peasus/spotifactory/site/img/gallery/printing.jpg

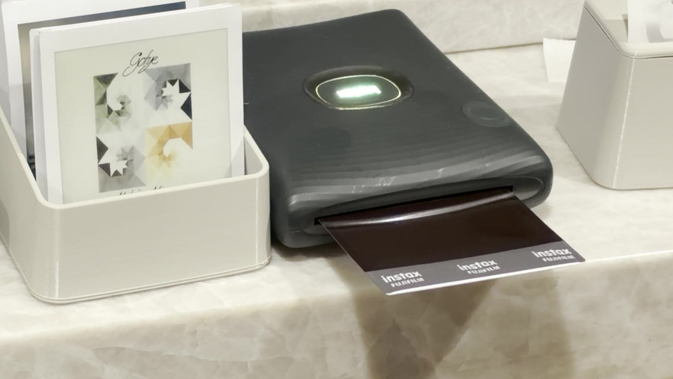
site/img/gallery/printing.jpg
