peasus/spotifactory/site/img/gallery/family.jpg

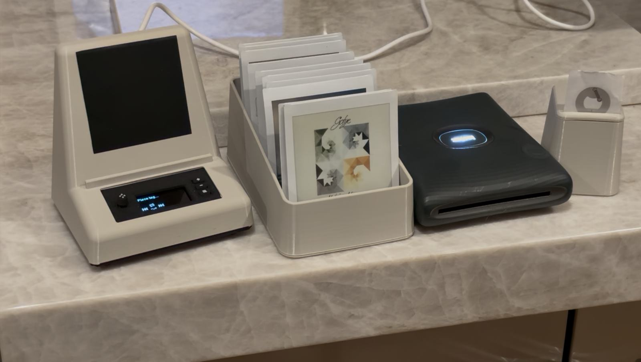
site/img/gallery/family.jpg
