peasus/spotifactory/site/img/gallery/box-angle-sm.jpg

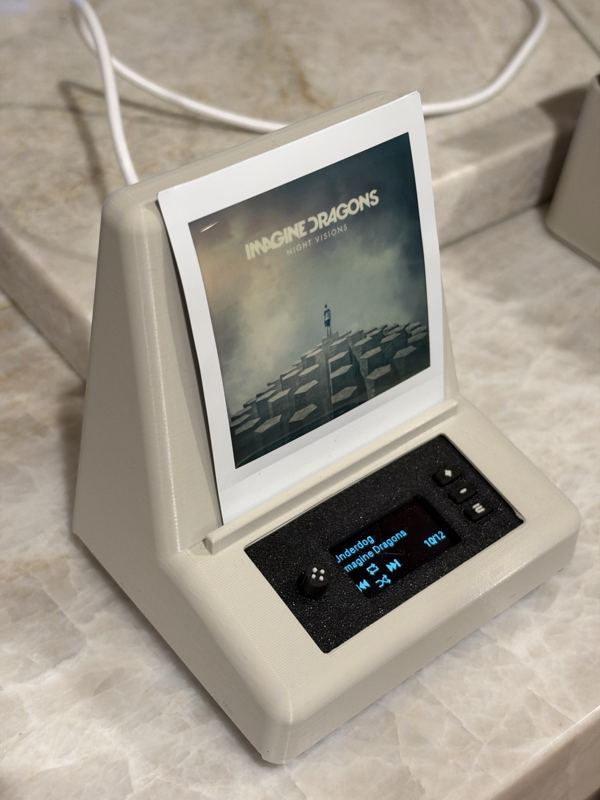
site/img/gallery/box-angle-sm.jpg
