peasus/spotifactory/site/img/gallery/box-back.jpg

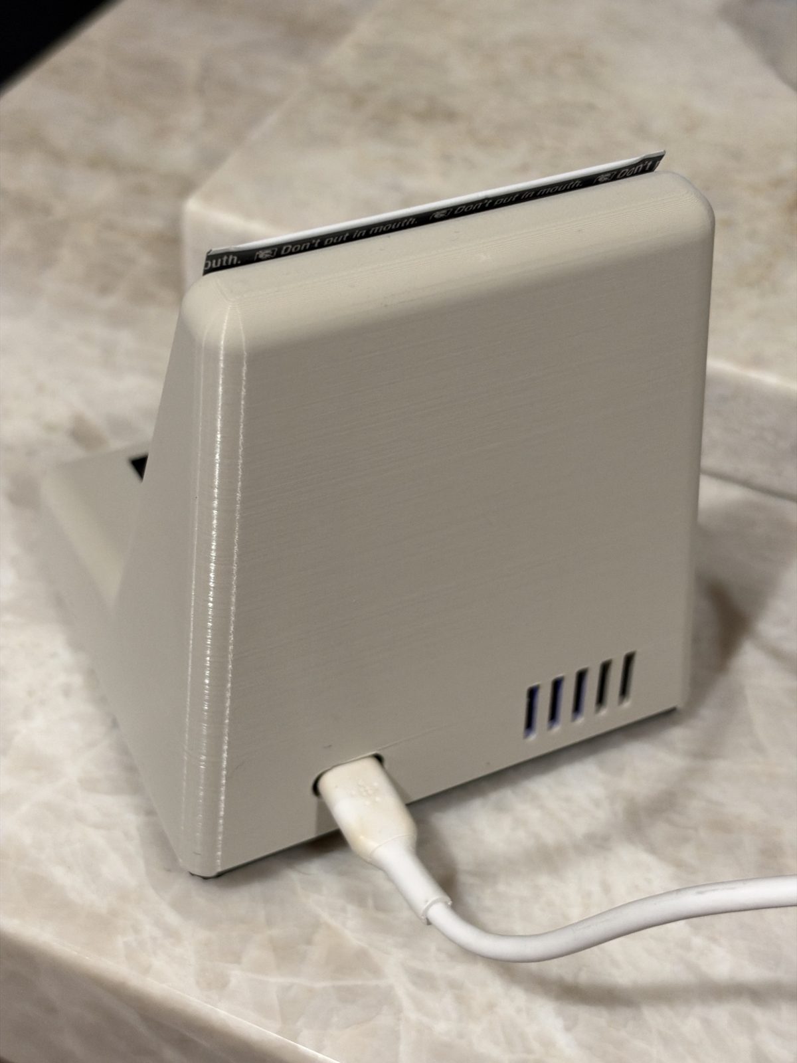
site/img/gallery/box-back.jpg
