peasus/spotifactory/site/img/gallery/box-front-sm.jpg

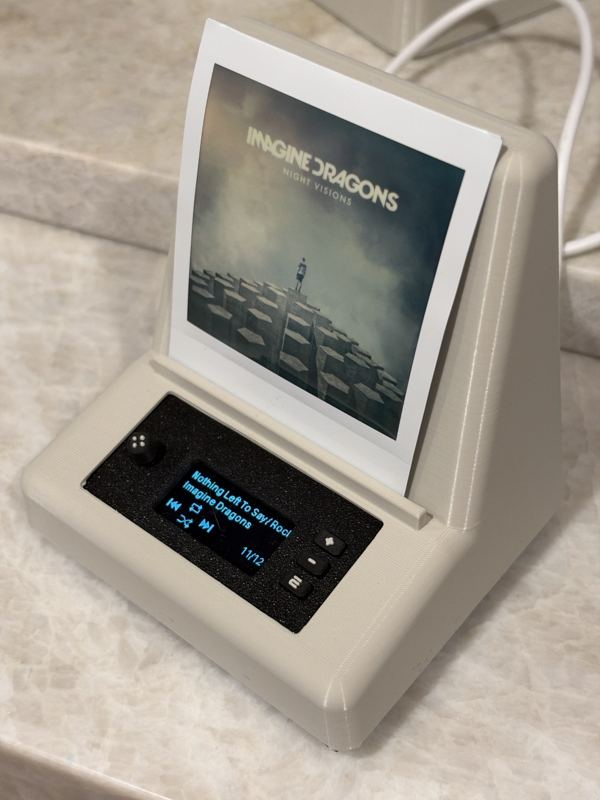
site/img/gallery/box-front-sm.jpg
