peasus/spotifactory/site/img/gallery/crate-full-sm.jpg

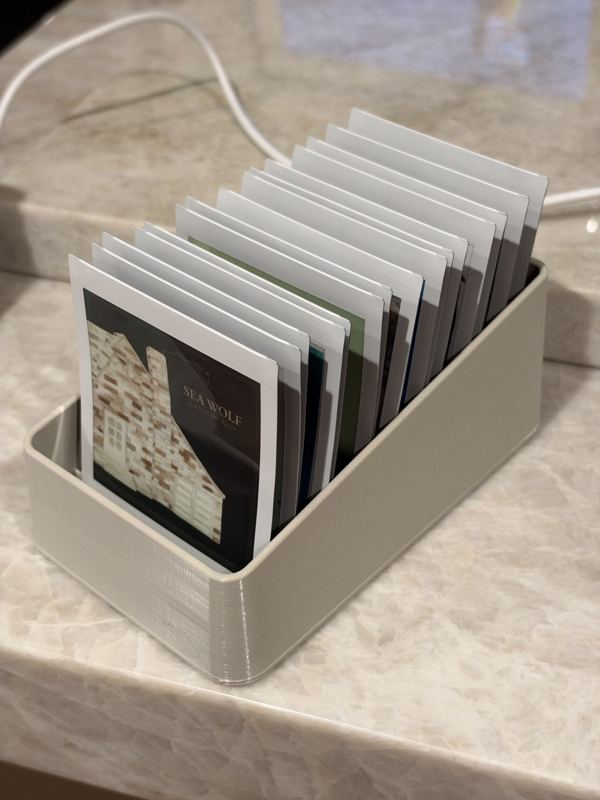
site/img/gallery/crate-full-sm.jpg
