peasus/spotifactory/site/img/gallery/dispenser-sm.jpg

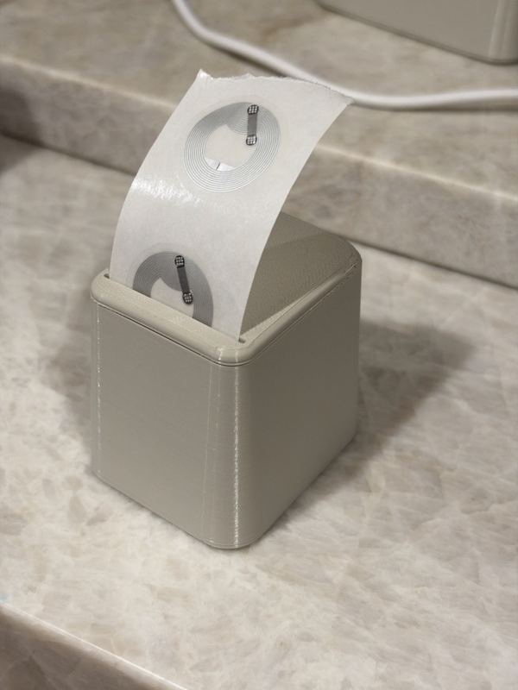
site/img/gallery/dispenser-sm.jpg
