peasus/spotifactory/site/img/gallery/placing.jpg

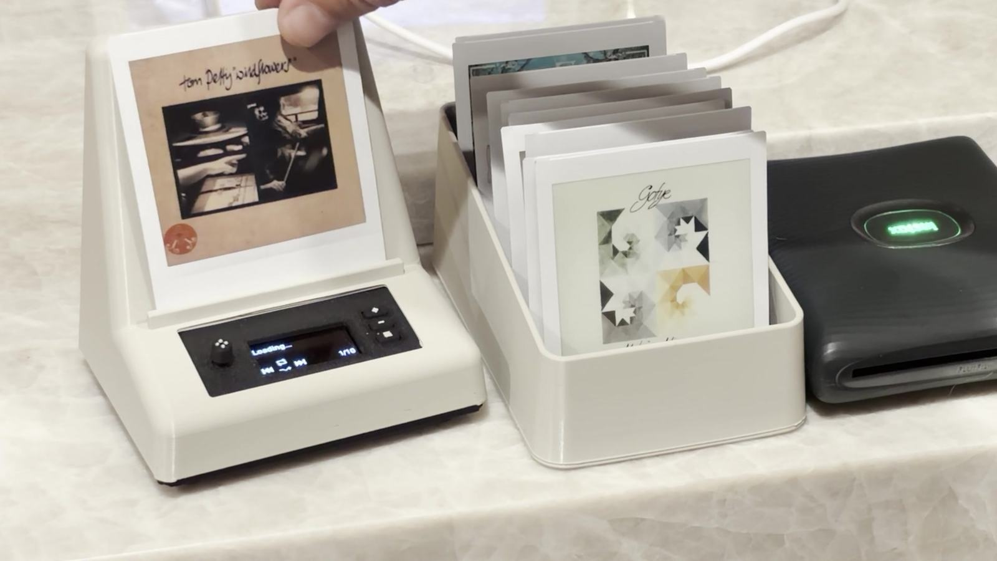
site/img/gallery/placing.jpg
