peasus/spotifactory/site/img/gallery/retro-clock-sm.jpg

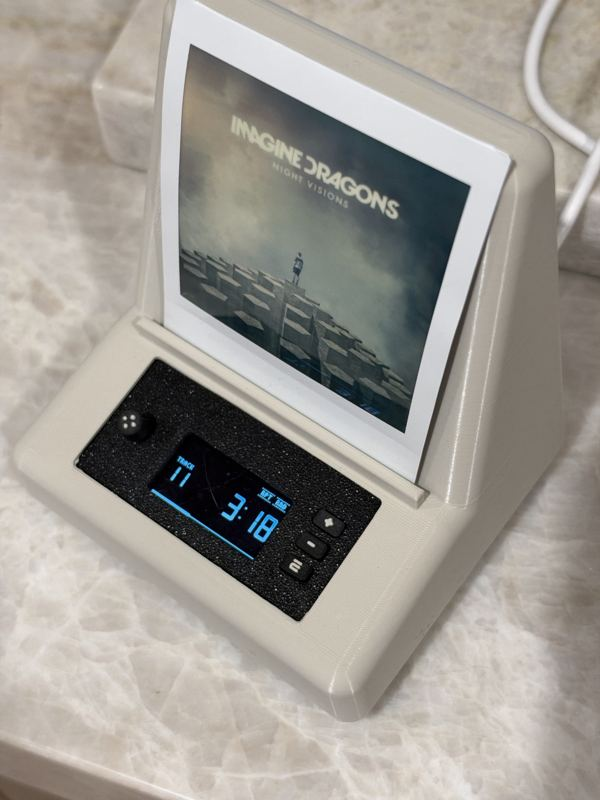
site/img/gallery/retro-clock-sm.jpg
