peasus/spotifactory/site/img/gallery/tagging-sm.jpg

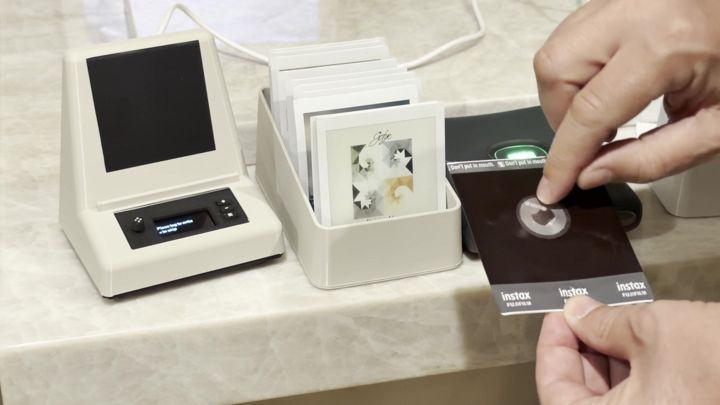
site/img/gallery/tagging-sm.jpg
