peasus/spotifactory/site/img/oled-ready.png

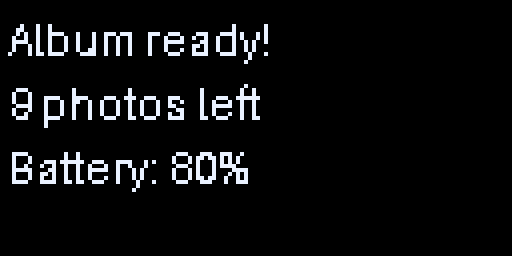
site/img/oled-ready.png
