peasus/spotifactory/site/img/oled-writing.png

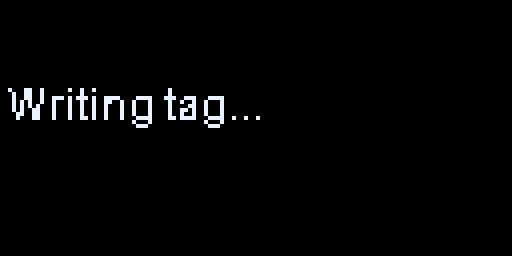
site/img/oled-writing.png
