peasus/spotifactory/site/portal.png

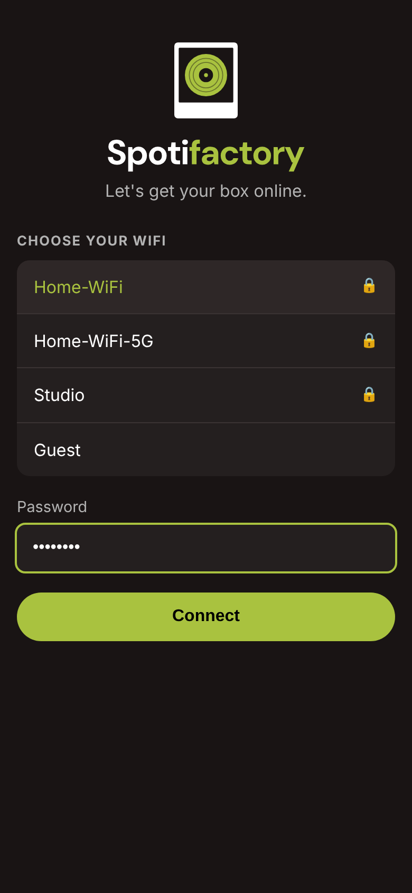
site/portal.png
