peasus/spotifactory/enclosure/bom_digikey.csv

Digi-Key Part Number | Quantity | Manufacturer | Manufacturer Part Number | Customer Reference
1528-5993-ND | 1 | Adafruit Industries LLC | 5993 | USB-C power socket (vertical breakout; 5.1k CC so any USB-C charger works)
1528-4255-ND | 1 | Adafruit Industries LLC | 4255 | M3 x 4 mm brass heat-set inserts (pack of 50; 4 used) for base plate bosses
SJ5003-0-ND | 4 | 3M | SJ-5003 (BLACK) | Rubber feet 11.2 mm x 5 mm
2648-SC0721-ND | 1 | Raspberry Pi | SC0721 | Raspberry Pi Zero 2 W with 40-pin header fitted
2648-SC1628-ND | 1 | Raspberry Pi | SC1628 | microSD card 32 GB
1528-2704-ND | 1 | Adafruit Industries LLC | 3878 | USB-C to micro-USB cable 1 m (reader to Pi; straight plugs fit)
 | 1 | Adafruit Industries LLC | 592 | USB-A to micro-USB cable 1 m (cut down for the power lead)
36-29306-ND | 4 | Keystone Electronics | 29306 | M2.5 x 16 pan head (slotted) for the Pi stack; use with the printed 2 mm washers
 | 4 | APM Hexseal | RM2.5X8-2701 | M2.5 x 8 pan head (Phillips) for the USB-C power board
