peasus/spotifactory/(commit log)

2025-11-23 Add run_debugpy.sh helper to run debugpy and wait for attach
2026-06-30 Add Instax Square Link printer support
    - Vendor javl/InstaxBLE source (instax_ble.py, Types.py, LedPatterns.py)
    - Add printer.py: thin wrapper around InstaxBLE for one-call printing
    - Add simplepyble dependency for BLE communication
2026-06-30 Wire album art capture to menu
    - Add NowPlayingInfo dataclass and get_now_playing() to spotify.py
    - Add CaptureJob: fetches artwork, prints via Instax, writes URI to RFID tag
    - Update printer.py to accept str | BytesIO
    - Add "Print Now Playing" as first menu item, lazily imports CaptureJob
2026-06-30 Rewrite menu system with Task/Step/Runner architecture
    Replaces the callback-based Menu/MenuItem model with a clean separation
    of concerns: pure data menus (MenuDef/ItemDef), non-blocking threaded
    Steps with typed StepOutcome returns, and a single platform-agnostic
    Runner that drives navigation and task execution.
    - tasks/base.py: Task, Step, Continue/PushMenu/Done/Cancel outcomes
    - tasks/capture/: CaptureTask with FetchInfo, Confirm, FetchArt, Print,
    Scan, Done steps — each self-contained and independently testable
    - menu/definitions.py + catalog.py: declarative menu tree, wired to
    tasks by class reference (no callbacks at definition time)
    - menu/navigation.py: NavStack replaces the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
2026-06-30 Add Play Tag task — scan RFID tag and play album on Spotify
    Three-step task: scan tag for URI, call start_playback on active
    Spotify device, show "Playing!" confirmation. Handles missing URI on
    tag, no active device, and generic Spotify errors gracefully.
2026-07-01 Add scrolling text for long menu labels + fix sim display sizing
    ScrollTracker (menu/scroll.py) drives a 3-phase loop per text position:
    3s pause → smooth scroll at 30 display px/s → 1s pause → repeat.
    Both renderers clip left-margin overflow with a background rect after
    shifting the text draw position by the scroll offset.
    Sim renderer: scale 6→4 (512×256 window), font scales with row height
    (scale*6 pt), tkfont.Font used for per-render text width measurement.
    OLED renderer: same scroll logic using Pillow textbbox for measurement.
2026-07-01 Remove album name truncation — scrolling handles long titles
    The [:18] slice prevented the ScrollTracker from ever seeing overflow,
    so long album names were silently cut off instead of scrolling.
2026-07-01 Add home screen, fix RFID on macOS, print progress, and nav flow
    - HomeTask/HomeScanStep: persistent scan-tag screen with now-playing
    display, << shuffle >> legend, and left/right prev/next controls
    - RFID: auto-detect cu.usbserial-* on macOS; fix nfcpy port string
    format so tty:usbserial works correctly with the PN532v1.6
    - Printer: separate printer_dry_run flag (safe on Mac sim), early
    no-film detection, upload percentage + Printing... progress via callback
    - Runner: return to home screen after every task completes; Up from
    home surfaces the menu; action="home" restarts HomeScanStep
    - Menu: remove non-functional items (Status, Settings, WiFi, Brightness);
    rename Play Tag -> Scan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
2026-07-01 Add shuffle active indicator dot to home screen icon
    Draw a small filled dot below the shuffle icon when shuffle is on,
    nothing when off — matching the Spotify app convention.
    - Switch get_now_playing() from currently_playing() to current_playback()
    so shuffle_state is available (the lighter endpoint omits it)
    - Thread shuffle_active through NowPlayingInfo → HomeScanStep → renderer
    - Add draw_circle() to both sim and OLED renderers
    - Reposition legend to cy=52 so the dot fits within the 64px display
2026-07-01 Show album and artist on print confirmation screen
    MenuDef gains an optional subtitle field; _render_menu draws it between
    the title and the items when present. The print confirmation menu sets
    album as the title and artist as the subtitle.
2026-07-02 Switch to event-driven RFID and reduce Spotify poll to 1s
    Replace application-level polling with nfcpy supervision mode: on_connect
    returns True so the PN532 natively detects tag presence and removal via
    on_release, eliminating the 0.8s poll loop. watch_tags() replaces
    read_card_cancellable and poll_for_tag in rfid.py.
    Reduce Spotify display refresh from 5s to 1s so song/artist updates
    feel immediate.
2026-07-02 Add Choose Speaker menu to select Spotify playback device
    FetchDevicesStep pulls the live device list from Spotify and builds a
    dynamic menu; SetDeviceStep calls transfer_playback on the selection.
    ItemDef gains a data field so any confirm action can carry a payload
    into ctx.data["selected"] without extra plumbing.
2026-07-02 Fix nav bugs: skip playback restart if already playing, don't pause on menu nav
    on_place now checks current Spotify playback before calling start_playback,
    so placing a tag for the already-playing album is a no-op. on_remove skips
    pause_playback when cancel is set, so navigating to the main menu no longer
    interrupts playback. Right arrow acts as select in menu contexts.
2026-07-02 Add Pi deployment: WiFi captive portal, Spotify OAuth server, systemd service
    startup.py is the Pi entrypoint: checks for network (launches Balena WiFi
    Connect if offline), checks for Spotify token (runs OAuth callback server if
    missing), then starts the main app. All stages show status on the OLED.
    auth_server.py is a stdlib http.server OAuth callback handler — no Flask
    dependency. GET / redirects to Spotify, GET /callback exchanges the code and
    shuts the server down.
    deploy/setup.sh installs system packages, enables I2C, sets hostname to
    spotifactory, installs Balena WiFi Connect, creates the venv, and registers
    the systemd service. spotifactory-pi added as a console script entry point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
2026-07-03 Switch Spotify auth to PKCE + Cloudflare Worker relay
    Spotify no longer allows http redirect URIs (including .local), so
    the previous auth_server approach was broken. PKCE solves this without
    a client secret on the device; the Worker relay acts as the redirect
    target so the Pi never needs an inbound port.
    Flow: Pi generates PKCE verifier → registers authorize URL with Worker →
    shows session URL on OLED → polls /poll/:id for the code → exchanges
    locally (no secret needed) → tokens saved to .cache.
    - deploy/relay/worker.js: KV-backed Worker with /register, /:id,
    /callback, /poll/:id routes
    - deploy/relay/wrangler.toml: Cloudflare deploy config
    - auth_server.py: replaced HTTP serv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
2026-07-03 Set relay Worker name to auth, add KV namespace ID
    URL: https://auth.spotifactory.workers.dev
    Redirect URI registered in Spotify Developer Dashboard.
2026-07-03 Show persistent no-active-device error on home screen
    When start_playback fails with NO_ACTIVE_DEVICE, display "No active
    device / Go to Choose Speaker" on the home screen instead of logging
    silently. A _device_error flag suppresses the polling status update
    so the message stays visible until the next successful scan.
2026-07-03 Show album artwork preview in macOS sim during print flow
    When printer_dry_run is True, opens the fetched artwork image in the
    system viewer (Preview on Mac) before the print step runs, so the
    correct album art can be visually confirmed without a real printer.
2026-07-03 Add Connect Spotify menu item with QR code display
    New ReAuthTask triggers a full PKCE relay auth flow from within the
    app — works on Mac for testing and serves as the in-app re-auth
    option on Pi. The auth screen shows:
    [QR code] tinyurl.com/
    xxxxxxx
    ^ Cancel
    - tasks/reauth/: QRAuthStep generates a V2 QR code (50×50px) from
    the TinyURL-shortened relay session URL and sets qr_image on the
    step for the runner to render; Up cancels the flow
    - auth_server.py: adds _shorten_url() (TinyURL API, falls back on
    error) and terminate= callback to _poll_for_code()
    - runner.py: _in_qr_auth() / _render_qr_auth() — dedicated render
    path for the QR screen; handle_up(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
2026-07-03 Add SeenGreat 1.3" OLED HAT (SH1106) display and input support
    - renderer_sh1106.py: luma.oled SPI driver, identical display interface to DisplayOLED
    - input_seengreat.py: RPi.GPIO polling for 5-way joystick + K1 as Back
    - run_on_seengreat.py: main loop entrypoint, spotifactory-seengreat script
    - pyproject.toml: luma.oled + RPi.GPIO in [rpi] extras, new script entry point
    - conftest.py: mock luma and RPi.GPIO modules for CI
2026-07-03 Fix reauth not switching Spotify account on reconnect
    Instead of invalidating the client and letting get_client() reconstruct
    a new auth manager from cache (which may not correctly pick up a
    PKCE-issued token), reuse the auth instance that just successfully
    exchanged the code and set it directly as the active client.
2026-07-04 Reorganize source into display/, input/, platforms/, hardware/ packages
    - display/: oled, sh1106, sim renderers + scroll tracker (was menu/)
    - input/: buttons, seengreat input handlers (was menu/)
    - platforms/: pi, seengreat, sim main loops (was menu/)
    - hardware/: printer, rfid (was top-level)
    - menu/ now contains only catalog, definitions, navigation
2026-07-04 Fix two stale paths missed in reorganization
    - play_tag/steps.py: rfid import → hardware.rfid
    - hardware/printer.py: update __main__ usage string module path
2026-07-04 Reduce home→menu transition lag in sim
    - HomeScanStep: replace time.sleep(0.1) with _cancel.wait(timeout=0.05)
    so the step thread wakes immediately when cancel() is called rather
    than sleeping the full 100ms
    - sim: call runner.tick() on every keypress so step completion is
    detected in the same frame as the input, not the next poll cycle
    - sim: tighten poll interval from 100ms to 50ms
2026-07-04 Fix ~1.6s home→menu lag caused by nfcpy ContactlessFrontend teardown
    nfcpy takes 1-2s to close the hardware after terminate() returns True.
    Run watch_tags in a daemon thread so the step returns Cancel() the
    instant _cancel is set, and nfcpy teardown happens in the background.
2026-07-04 sim: disable printer_dry_run for live print testing
2026-07-05 Add Sonos SoCo fallback, device-aware playback, and Print Playlist
    - Route playback through SoCo when Spotify reports a restricted Sonos
    device; cache discovered speaker to avoid repeated UPnP discovery
    - get_playback_device() prefers explicitly chosen speaker, then active
    Spotify Connect device, then active device from devices list
    - Persist chosen device via set_active_device() after Choose Speaker
    - Add Print Playlist task: fetches playlist context, cover image, and
    writes playlist URI to RFID tag (shares PrintStep with Print Album)
    - Rename "Print Now Playing" → "Print Album" in main menu
    - Improve error messages for restricted/no-active-device cases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
2026-07-06 Fix Pi deployment for SeenGreat HAT and playlist improvements
    - Add [seengreat] pip extra (luma.oled + RPi.GPIO, no Adafruit deps)
    - Fix [rpi] adafruit-circuitpython-ssd1306 version constraint (was >=4.0.0, max is 2.x)
    - startup.py: select display + platform via SPOTIFACTORY_PLATFORM env var (default: seengreat)
    - setup.sh: detect aarch64 and download correct 64-bit WiFi Connect binary; non-fatal on failure
    - setup.sh: install [seengreat] or [rpi] based on .env SPOTIFACTORY_PLATFORM
    - env.example: add SPOTIFACTORY_PLATFORM=seengreat
    - Print Playlist: fall back to track art for auto-generated playlists (API returns 404)
    - Print Playlist: use sp._get() to avoid additional_types=track param cau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
2026-07-06 deploy: enable SPI in setup.sh for SeenGreat HAT
2026-07-06 Fix as_dict kwarg crash when PKCE code arrives on Pi
    SpotifyPKCE.get_access_token() does not accept as_dict — would have
    crashed the auth flow the moment the user completed Spotify login.
2026-07-06 Switch SeenGreat OLED driver from SPI to I2C
    SPI wiring has a bad joint; display responds correctly on I2C at 0x3C.
    SW1=0, SW2=0 on the HAT selects I2C mode. I2C is sufficient for all
    display update rates in this project.
2026-07-06 Show QR code on startup auth screen instead of text URL
    Matches the reauth flow: QR image on left, 'Scan to connect Spotify'
    label on right. Easier for the recipient to use on first boot.
2026-07-06 Auto-detect PN532 serial port on Linux; add dialout group
    On Pi, /dev/ttyUSB0 (CH340 converter) is the correct port. The old
    Linux default 'tty:usbserial-210' was a macOS-style name. Now scans
    /dev/ttyUSB* and /dev/ttyACM* and picks the first found device.
    Also adds 'dialout' group to setup.sh so the service user can open
    serial ports without sudo.
2026-07-06 Fix SeenGreat HAT joystick GPIO pin mapping
    Corrected from empirical testing on hardware — the documented pin
    assignments did not match the actual HAT wiring.
2026-07-06 Add Bluetooth auto-enable and NFC_PORT to deploy setup
    - Enable bluetooth service and unblock rfkill at setup time
    - Set AutoEnable=true in /etc/bluetooth/main.conf so controller
    powers on automatically after every reboot
    - Set NFC_PORT=tty:USB0 explicitly in env.example so the Pi always
    uses the correct serial port without relying on auto-detection
2026-07-06 Fix Instax BLE connection on Linux: prefer ANDROID advertisement
    On Pi/BlueZ, the (IOS) BLE advertisement address fails with
    le-connection-abort-by-local. The (ANDROID) address connects
    successfully. Sort scan results to try ANDROID first, and accept
    any INSTAX- device (not just IOS) for broader compatibility.
2026-07-06 Add Bluetooth Classic RFCOMM backend for Instax printing on Pi Zero 2W
    BCM43438 BLE GATT service discovery consistently fails, but the Instax
    Square Link also exposes a Classic BT RFCOMM interface (the ANDROID
    address) on port 6 which works fine. Derive the Classic BT address from
    the BLE IOS scan (FA:AB:BC → 88:B4:36) and connect via socket instead.
2026-07-07 Document Sonos S2 playback limitation and clean up non-functional code
    Sonos S2 (ERA 100, Beam, Arc Ultra) blocks programmatic Spotify playback
    via both the Web API (is_restricted: True) and SoCo SMAPI (Error 800 since
    Dec 2024 firmware). Pause via SoCo UPnP still works reliably.
    - Add docs/sonos.md covering root cause, investigated approaches, and
    what to watch for if Sonos/Spotify re-enable programmatic control
    - Strip sonos.py down to just pause_speaker() + _get_speaker() helper
    - Fix steps.py: on restricted device, set _soco_speaker immediately so
    tag-remove pause still works via SoCo; remove broken play attempt
    - Delete debug_sonos_spotify.py and test_sonos.py (tested broken paths)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
2026-07-07 Fix dhcpcd conflict and update relay URL in env.example
    On Bullseye, dhcpcd conflicts with NetworkManager which wifi-connect
    requires. The Balena installer handles this on 32-bit but our custom
    aarch64 path didn't. Disable dhcpcd explicitly (no-op on Bookworm).
    Also update env.example relay URL from placeholder to the deployed
    Cloudflare Worker URL.
2026-07-08 Add standalone playback via Raspotify + Bluetooth speaker
    - Raspotify (librespot) runs as a systemd service on the Pi, appearing as
    "Spotifactory" in Spotify Connect — no Sonos or phone required for playback
    - BlueAlsa bridges the BT speaker to ALSA so Raspotify can stream to it
    - New "Pair Speaker" menu item scans for BT devices, pairs/trusts/connects,
    writes /etc/asound.conf, and persists the MAC to .env for boot reconnect
    - Tag scan uses 3-tier play logic: explicit Choose Speaker choice → Raspotify
    → fallback to active Spotify device
    - "Connect Spotify" now follows QR auth with a Zeroconf prompt so both the
    Web API token and Raspotify's audio stream are tied to the same acco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
2026-07-08 Fix bluetooth scan and pairing
    bluetoothctl --timeout exits before printing device lines; instead start
    scan as a background Popen, sleep, terminate, then query `bluetoothctl devices`.
    Pairing commands (agent/pair/trust/connect) now run in a single piped session
    so device state and agent registration are shared.
2026-07-08 Fix BT scan to only show currently-advertising devices
    `bluetoothctl devices` returns all previously-known devices (including
    powered-off ones). Instead, capture [NEW] Device lines from the live
    scan process stdout so only devices actively advertising appear in the list.
2026-07-08 Fix BT scan using PTY so bluetoothctl flushes output
    bluetoothctl only outputs [NEW] Device lines when it thinks it's on a
    terminal. With a plain pipe it block-buffers and we see nothing. Open a
    PTY (pseudo-terminal) for all bluetoothctl sessions so output is
    flushed line-by-line as on a real terminal. Also applies PTY to
    pair/trust/connect so the full pairing session shares agent state.
2026-07-08 Fix BT device names showing as MAC addresses
    bluetoothctl emits [NEW] Device with the MAC as the name initially, then
    resolves the real name via [CHG] Device MAC Name: <name> asynchronously.
    Now track both events and update the name when CHG arrives, so the list
    shows "Sonos Roam" instead of "AA:BB:CC:DD:EE:FF".
2026-07-08 Filter anonymous BLE devices from pair list
    Anonymous BLE devices (phones, earbuds) broadcast hex strings as their
    name — not a MAC, but not human-readable either. Filter out any name
    that is purely hex/punctuation characters, leaving only real device names.
2026-07-08 Fix Connect Spotify not showing Zeroconf prompt
    QRAuthStep was returning Done() which ends the entire task immediately.
    Changed to Continue() so the runner advances to ZeroconfPromptStep,
    which prompts the user to open Spotify and select Spotifactory as a device.
2026-07-08 Fix BT pairing: check pair success before trust/connect
    Previously all commands ran in sequence regardless of failures, leaving
    the device in a Trusted:yes Paired:no state. Now pair runs first and
    raises immediately on failure, so trust/connect only run after a
    successful pairing handshake.
2026-07-08 Keep scan active during BT pairing; improve error logging
    bluetoothctl pair needs scanning active so BlueZ can reach the device.
    Add 'scan on' before 'pair' in pair_and_configure. Print full pair/connect
    output to console so failures are visible in journalctl logs.
2026-07-08 Fix scan missing previously-known BT devices
    BlueZ only fires [NEW] Device the first time a device is seen; subsequent
    scans emit [CHG] Device events instead. Now track MACs from both [NEW] and
    [CHG] events. For any MAC whose name wasn't resolved from scan output,
    fall back to bluetoothctl info to get it from the local cache.
2026-07-08 Switch from BlueAlsa to PipeWire for BT audio on Pi OS Bookworm
    bluealsa is not in the Bookworm repos. PipeWire is the modern replacement
    and is available. Changes:
    - setup.sh: install pipewire/wireplumber/libspa-0.2-bluetooth/pipewire-alsa/
    pipewire-pulse; enable PipeWire as user service with loginctl linger;
    override Raspotify service to run as spotifactory user so it shares
    the same PipeWire session
    - raspotify.conf: use --backend pulseaudio (PipeWire's compat layer)
    - bluetooth.py: replace write_asoundrc (BlueAlsa) with set_bt_audio_output
    which calls pactl set-default-sink to point PipeWire at the BT speaker
2026-07-08 Fix BT audio: use autologin instead of loginctl enable-linger
    PipeWire/WirePlumber need a real login session with D-Bus and seat
    context to register A2DP profiles with BlueZ. loginctl enable-linger
    starts the user manager but not a full session — BT connections fail
    with br-connection-profile-unavailable as a result. Console autologin
    (raspi-config B2) creates the proper session at boot.
2026-07-08 Fix Raspotify audio, BT scan quality, and Spotify polling
    - Run Raspotify as a user service (not system) so it shares PipeWire session without user-namespace auth issues; setup.sh updated accordingly
    - Remove deploy/raspotify.conf — Raspotify reads LIBRESPOT_* env vars, not that file
    - Filter BT beacons by Connectable:no property rather than name regex
    - Only accept device names from explicit Name:/Alias: CHG events (not RSSI etc.)
    - Add Instax printer pairing to Pair Device flow: detects INSTAX- prefix, derives Classic BT address, saves INSTAX_BT_ADDRESS to .env
    - Rename "Pair Speaker" menu item to "Pair Device"
    - Stop polling Spotify when idle (no tag placed) — only poll every 5s while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
2026-07-08 Fix dual display instance and make display failures non-fatal
    Pass the startup display into the platform instead of creating a second
    DisplaySH1106 on the same I2C address. Wrap render() so display hardware
    failures (e.g. damaged connection) don't crash the app — RFID and audio
    keep working even with a dead screen.
2026-07-08 Only write to I2C display when frame content changes
    Reduces display writes from 20/sec to only on actual changes.
    Helps damaged connections and reduces bus load generally.
2026-07-09 Improve home screen UX, screen saver, and playback resume behaviour
    - Screen saver: blank display after 10 min idle; any button press wakes it
    - Tag placed: show "Loading..." immediately and poll after 1.5 s instead of
    waiting the full 5 s interval for the first now-playing update
    - Tag removed: immediately reset display to "Place tag..." idle state
    - Resume vs restart: use get_current_context() (includes paused state) to
    decide whether to resume at current position or start the album from track 1;
    fixes the speaker-change-then-tag-rescan restarting the album
    - Left/Back from root menu returns to the home scan screen
    - Menu item scroll animation: remove hard 18-char truncation so long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
2026-07-09 Auto-reset PN532 UART on reconnect instead of requiring physical replug
    When nfcpy exits mid-session (crash, restart, daemon thread killed) the
    PN532 can be left in an unknown UART state — mid-frame, mid-response, or
    stuck in supervision mode. The next init sequence is then silently ignored,
    requiring a physical unplug/replug to recover.
    Fix: send a serial BREAK signal before each ContactlessFrontend open to
    reset the PN532's UART state machine to idle, then retry up to 3 times
    on failure. The BREAK holds TX low for 250 ms (well over the 1-frame
    threshold) followed by an input/output buffer flush.
2026-07-09 Fix RFID reader recovery after Ctrl+C or process crash
    Two problems, two fixes:
    1. Ctrl+C left PN532 in bad state (daemon thread killed mid-session,
    nfcpy ContactlessFrontend.__exit__ never ran). seengreat.py now catches
    KeyboardInterrupt, cancels the running step, and waits 2.5 s for nfcpy
    to tear down cleanly before exiting.
    2. When the CH340 USB-serial chip enters ENODEV state (from an abrupt
    disconnect), a UART flush alone cannot recover it — only a USB-level
    reset can. Added _usb_soft_reset() which toggles the sysfs 'authorized'
    file (the software equivalent of unplugging and replugging). Retry
    logic: attempt 1 = UART flush, attempt 2 = USB soft-reset + 1.5 s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
2026-07-09 Fix USB soft-reset sysfs path and timing
    Two bugs in the previous USB reset implementation:
    - Was stopping at the interface node (1-1:1.0) which also has 'authorized'
    on modern kernels, instead of the device node (1-1). Fixed by skipping
    nodes whose names contain ':' when walking up the sysfs tree.
    - Was using a fixed 1.5 s sleep after reauthorize; if re-enumeration took
    longer the next nfcpy attempt still failed. Now polls for /dev/ttyUSBx
    to reappear (up to 15 s) before retrying.
    - Added a 4th attempt (plain retry after USB reset) so the reconnect
    attempt happens after the device has fully come back up.
2026-07-09 Simplify RFID recovery: show hint + auto-retry after replug
    The CH340 firmware hang (caused by abrupt process kill) requires a physical
    replug — no software can recover a device that has stopped enumerating on
    the USB bus. The previous USB sysfs reset attempts added complexity without
    helping in this failure mode.
    Simplified to:
    - rfid.py: 2 attempts (plain open, then UART flush + retry)
    - home/steps.py: when RFID unavailable, show "Replug RFID reader" on the
    display and retry watch_tags every 30 s — so a physical replug
    auto-recovers without needing a restart
    - Removed the sysfs USB reset code and its sudoers entry from setup.sh
    The Ctrl+C cleanup in seengreat.py (cancels the step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
2026-07-09 Fix home screen responsiveness, BT reconnect loop, and print confirmation screen
    - Home screen: restart nfcpy watch loop on unexpected exit so the first
    tag scan no longer drops back to the menu on PN532 supervision edge cases
    - Home screen: pause playback unconditionally on tag remove instead of
    checking get_now_playing() first (race condition when tag removed quickly)
    - Home screen: poll Spotify immediately after tag placement instead of
    waiting 1.5s; keep "Loading..." if API not ready yet rather than resetting
    to "Place tag..."
    - Startup: BT reconnect runs as a persistent 30s retry loop so the speaker
    can be turned on any time after Spotifactory starts
    - Print confirmation: show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
2026-07-09 Route Raspotify audio to BT speaker on reconnect via move-sink-input
    set_bt_audio_output() only updates PipeWire's default sink, which
    affects new streams. Add move_sink_inputs() to explicitly redirect any
    already-running librespot stream to the BT sink — so Raspotify switches
    without restarting when the speaker connects after Spotifactory boots.
    Both the pairing step and the startup reconnect loop now call both
    functions. Extracted move_sink_inputs() as a shared helper in
    bluetooth.py and removed the duplicated subprocess logic from
    bluetooth/steps.py.
2026-10-09 Fix hanging test suite and boot-time network/audio issues
    - Tests: TestStartupMain stubbed the old `pi` platform, but startup now
    defaults to seengreat, so main() entered the real button loop and CI
    ran to the 6h timeout on every push. Stub _make_display/_run_platform
    instead. Fix stale as_dict assertion in the PKCE test. Add a 10-minute
    CI job timeout as a backstop.
    - Boot: wait up to 30s for saved WiFi before launching the captive
    portal, and order the unit after network-online.target.
    - Audio: give the systemd unit XDG_RUNTIME_DIR so pactl can reach the
    user's PipeWire session. The BT reconnect loop now routes audio on any
    connect (including BlueZ auto-reconnects) and retrie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
2026-10-09 Fix confusing menu flows and pause music while printing
    - Tag write after printing no longer hangs forever: Back skips it, it
    gives up after 2 minutes, and an unwritable tag (not NDEF, read-only)
    shows why and waits for another instead of reporting "Album ready!".
    - Back (and Left) now cancel cancellable running steps: tag write, QR
    login, and the "tap Spotifactory" prompt.
    - Menus return to the home screen after 60s idle, since tags only work
    there. The timer restarts whenever a menu is pushed.
    - Reboot and Shutdown ask for confirmation, defaulting to Cancel.
    - Buttons fire once per press instead of repeating while held.
    - Pause Spotify while printing if it's playing on this device: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
2026-10-09 Update setup.sh next-steps text
    Drop the stale :8080 redirect URI step, rename Pair Speaker to Pair Device,
    and note that the service must be stopped before running by hand.
2026-10-09 Don't fail printer pairing on the expected connect error
    The Instax has no BlueZ profile, so `bluetoothctl connect` always fails
    with NotAvailable after a successful pair. That was reported as
    "Paired but could not connect" and skipped saving INSTAX_BT_ADDRESS.
    Printers now pair + trust without connecting, and the address is applied
    to the running process immediately. Re-pairing an already-paired device
    (AlreadyExists) no longer counts as a failure, and pairing errors are no
    longer cut to 20 characters since the display scrolls long text.
2026-10-09 Run a BT agent while connecting to the Instax
    The printer asks to confirm a passkey on every RFCOMM connect. On a fresh
    Pi OS (Trixie, BlueZ 5.82) no agent is registered, so BlueZ refuses with
    "No agent available" and connect() fails with EACCES, which showed up as
    "Printer Off?". Run an auto-accepting bluetoothctl agent for the duration
    of the connect only, so the Pi isn't left accepting pairings from anyone.
    Also log RFCOMM connect failures even in quiet mode.
2026-10-09 Remember the chosen speaker, and keep Raspotify's login
    The Choose Speaker pick lived only in memory, and tags otherwise fell
    back to Spotify's "active device", which expires after idle. So after
    sitting a while tags had nowhere to play, and the device showed the
    misleading "Open Spotify: select Spotifactory" hint.
    - Persist the chosen speaker (id + name) in .env via a shared
    settings.save_setting(), also used for the BT speaker and printer.
    - Tags play on the chosen speaker, re-resolved by name if its id
    changed. If it's missing or doesn't respond (idle Echos 404), say so
    by name instead of silently playing in another room.
    - Choose Speaker saves the pick even when the speaker is asl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
2026-10-10 Update the shuffle icon instantly when Down is pressed
    The icon only refreshed on the 5s now-playing poll, and only while a tag
    was on the reader. Flip it immediately on press, then set it to the state
    Spotify confirms (or revert if nothing is playing / the call fails). Polls
    leave the icon alone for 3s after a change, since Spotify can briefly
    report the old state. The API calls now run off the UI thread, and a
    second press is ignored until the first change completes.
2026-10-11 Add a scrollbar to menus that don't fit on screen
    The main menu shows 4 of its 8 items with no sign that more exist. Draw
    a slim bar on the right edge (dotted track, solid thumb) whenever a menu
    has more items than visible rows; the thumb's size and position follow
    the scroll. A cleared strip keeps it visible beside a highlighted row.
    Adds draw_rect() to the SH1106, SSD1306 and simulator displays.
    Also point the tag-write and Spotify-prompt hints at the joystick
    ("< to skip", "< when done"), since the K buttons are going away.
2026-10-13 Add parametric enclosure model (build123d)
    Easel-style case: screen and joystick on a 12° face, the Instax print
    standing in a groove against a panel that holds the PN532 behind the tag.
    Uses measured board dimensions, the SeenGreat HAT drawing and Adafruit's
    STEP model of the 5993 USB-C breakout. Renders previews and checks parts
    for collisions. Generated renders/STLs go to enclosure/out (ignored).
2026-10-13 Split the enclosure into printable parts and add fit/print checks
    - Body (printed upright): the slope's top skin becomes a separate
    faceplate; remaining inside ledges are propped by 45° wedges so it
    prints without supports. Bosses for M3 heat-set inserts, back vents,
    USB-C breakout posts, reader rails and top slot (also the warm-air exit).
    - Faceplate (printed face down): drops in from inside under a 1.2 mm lip;
    shoulders + pins locate the HAT by its mounting holes, pocket clears
    the unused K1-K3 buttons.
    - Base plate (printed flat): screws into the inserts; posts press the Pi
    up so the whole stack clamps against the faceplate (no screws into the
    faceplate). Vent slots under t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
2026-10-13 Fix login prompt hang, relay open redirect, RFID spin, artwork crash
    - Spotify login on the device never waits on the terminal: with no saved
    login, spotipy's PKCE fallback printed a URL and blocked on input(),
    hanging a hand-run app. _DevicePKCE raises instead, so callers treat it
    as "not logged in" and the QR flow runs.
    - Auth relay: /register only accepts Spotify's own authorize URL (https,
    accounts.spotify.com/authorize) and hex session ids, so the relay can't
    be used to redirect people to arbitrary sites.
    - Home screen: pause 1 s before reopening the NFC reader after an
    unexpected exit, so a failing reader doesn't spin on the serial port.
    - get_now_playing handles podcast ep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
2026-10-13 Rewrite README; add print-bed renders and DigiKey parts list
    - README describes the project as it is now: hardware, controls, Pi
    setup and updates, Mac development, the enclosure, and repo layout.
    - Replace the stale Copilot instructions (they described files that no
    longer exist) with a short, accurate architecture note.
    - pyproject: real description, drop placeholder email, require 3.9+.
    - Enclosure: print_layout.png shows each part on a bed from above and
    at bed level; bom_digikey.csv imports into DigiKey's BOM Manager.
2026-10-13 Enclosure v2: fixes from the first test print
    - Insert bosses are merged into the corner walls and stand on the bed
    (they were free-standing rings 0.5 mm off the wall and printed badly).
    - Under the shelf, a vertical wall from the bed replaces the hanging 45°
    wedges (their bottom edges floated and printed as spaghetti); a 45°
    chamfer props the shelf's front edge, and an opening passes the Pi's
    cables to the back bay.
    - Reader goes in from below and presses onto four tapered nubs in its
    mounting holes, flat against the panel (no rails, no top slot). Needs a
    right-angle USB-C plug turned to send the cable backwards.
    - Panel top has a 45° peaked roof inside, so it prints without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
2026-10-13 Re-detect the NFC reader's port on every open
    The port was fixed at import (NFC_PORT, else the first ttyUSB found).
    After a replug Linux renumbered the reader to ttyUSB1 while .env still
    said tty:USB0, so the home screen retried a missing device forever.
    current_port() keeps NFC_PORT only if that device exists, otherwise
    auto-detects, and is called on every open, so retries pick up the new
    port without a restart. env.example no longer sets NFC_PORT by default.
2026-10-13 Lean the enclosure back in like the sides
    The back wall now tapers in at the side angle (6.3°), keeping 14 mm of
    depth at the top, so the base grows from 81 to 92 mm deep. Stability
    improves (about 54 g to tip it backwards at the print, was 28 g). The
    USB-C bracket, socket, vents and roof follow the leaning wall.
2026-10-13 Enclosure: board gap (8.5 mm) and reader hole (3.0 mm) are measured
2026-10-14 Add a print crate; countersink the base plate and thicken its posts
    Crate: a record-bin style box for 40 Instax prints, with a rim that
    slopes down to the front so the covers show, saw-tooth floor ridges
    that keep the prints fanning, and walls that lean in like the easel's.
    Base plate: the four corner M3 holes get 90° countersinks for
    flat-head screws (the 45° sides print face down without support).
    The Pi posts now lean with the Pi so the screw-head pocket is coaxial,
    replacing a 0.6 mm wall that broke through on the front posts.
2026-10-14 Crate slots, watertight body STL, and the screw list
    Crate: 40 slots between 20 mm fins (3° lean, round tops) replace the
    floor ridges, with room in front to bend prints forward and a back gap
    sized for the leaning prints against the inward-leaning wall.
    Body: the partition under the shelf is 3.6 mm thick. At 2.4 mm its back
    face passed 0.4 mm from the panel's inside fillet and the STL had
    non-manifold edges. check.py now checks every exported STL for them.
    README: list all three screw sets, and note that the stack screws need
    pan or button heads to fit the base plate's post pockets.
2026-10-15 Reader caps and keepers; tag dispenser; crate and fit tests
    Body: the reader's pegs printed oversize (they stick out sideways from
    a leaning wall), so the reader now sits in caps over its top corners
    and is held at the bottom by two printed keepers. Each keeper has an
    M2.5 x 12 screw driven straight up into a post with a sloped underside
    that prints without supports. The wall under the shelf blocked the
    reader's plug and one keeper screw, so it's gone; short stubs remain at
    the side walls (without them that corner meshes with non-manifold
    edges). Stack screws can be M2.5 x 14, or M2.5 x 16 with the printed
    washers now in the spacers print.
    Dispenser: a box for the NFC sticker roll, with a s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
2026-10-16 Reader mount from the section test prints; shelf support that prints
    Reader: caps 9.4 mm long and 0.5 mm narrower (0.15 each side), so the
    board fits snugly. Keepers sit 0.3 mm higher, pushing the board up to
    the stops; their lips are 5 mm tall and they reach 8 mm under the board,
    past its rounded corners. The keeper posts touch the board's edges, and
    their screws sit 1 mm further back, so a 7 mm screwdriver shaft fits.
    The reader sits 6 mm off-centre to keep its plug clear of the Pi's.
    Under the shelf: a 5 mm partition and the 45° chamfer in front of it.
    The screwdrivers go through round holes; the partition only has gaps
    for the Pi's power plug and the reader's plug (a regular straight
    U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
2026-10-16 Fix Reboot/Shutdown; straight reader cable; reader 2.5 mm off-centre
    Reboot and Shutdown did nothing: they ran `sudo reboot` / `sudo shutdown`,
    which the service user can't do without a password, and the failure was
    ignored. They now run `sudo -n systemctl reboot|poweroff`, show a message
    on screen (or why it failed), and do nothing in the simulator. The
    passwordless rule moves into deploy/sudoers.sh, which setup.sh calls and
    an existing Pi can run on its own; a test keeps the two in step.
    Enclosure: the Pi's USB plug and the reader's plug now share one opening
    under the shelf, so the reader cable can be a regular straight cable at
    both ends. Over the middle of it the chamfer is gone and th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
2026-10-18 Setup fills .env from a provisioning file; power bracket fits the board
    setup.sh merges deploy/provision.env (git-ignored; or
    ~/spotifactory-provision.env on the Pi) into each box's .env before the
    Python install, so a new box needs no hand editing. deploy/apply_env.py
    replaces a key's line in place (a commented example too), appends new
    keys and ignores blanks; a test covers it. The README shows the scp.
    Power bracket: the window was a fully rounded slot, so the socket's
    square collar hit its ends and wouldn't seat, and the shell had play.
    Now a square pocket for the collar (0.3 mm clearance), a snug slot for
    the shell (0.1 mm), and a 1.5 mm recess behind the board so solder
    joints don't h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
2026-10-18 Auto-update from a stable branch; project Spotify app as the default
    Boxes update themselves from the `stable` branch: nightly (a systemd
    timer, ~3:30 with a random delay) unless someone's using the box, or now
    from the new menu item Check for Updates. deploy/update.sh fetches, checks
    out the new revision, reinstalls Python packages if pyproject.toml
    changed, runs deploy/upgrade.sh, restarts the app and waits for its
    heartbeat. If the app doesn't come back it rolls back and remembers the
    bad revision. SPOTIFACTORY_UPDATE_BRANCH and SPOTIFACTORY_AUTO_UPDATE in
    .env change the branch or turn the nightly run off.
    deploy/upgrade.sh installs the service, the updater's service and timer,
    and the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
2026-10-18 Updater: check the new app really came up; power bracket fit
    The rollback test on the Pi passed a release that crashes on start: the
    health check looked for a heartbeat newer than the update's start, which
    the old app kept writing until the restart, and a crashing app reads
    "active" for a moment after each automatic restart. Now the heartbeat is
    removed before the restart, and once the new app writes one, the
    updater waits 10 s more and checks systemd hasn't restarted it.
    Power bracket, from the fit test: the collar pocket is 2.5 mm deep (1.7
    was too shallow) and the shell slot 0.5 mm lower (the shell model was
    too tall; the slot keeps 0.1 mm clearance round it).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
2026-10-18 Body 2 mm taller underneath; power board 0.5 mm further in
    Everything inside sits 2 mm higher above the base plate (UNDER_CLEAR
    3.5), for more room for the reader's downward cable; the base plate's
    posts grow to match. The power bracket is 0.5 mm thicker on the board
    side, so the USB-C socket ends 0.7 mm inside the back wall instead of
    poking out. The bracket test print fits.
    Over the wide opening under the shelf, the shelf is a ~25 mm bridge
    (the screen's pocket in front, the panel behind, nothing below once the
    chamfer's side slopes run out), not the 3 mm ledge the check reported:
    that pass depended on where its 0.3 mm slices fell. The strip is now
    listed in easel.supported_bridges() (pri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
2026-10-20 Volume up/down and play/pause on the three buttons beside the screen
    K1 (top) and K2 turn the playing device's volume up and down by 5%,
    repeating while held; K3 plays or pauses. A volume bar shows for a
    moment after each press. Presses that arrive while Spotify is still
    answering are added up and sent together, so holding a button doesn't
    build a backlog. Devices Spotify can't set the volume of (supports_volume
    false, or restricted like Sonos) show "Volume: use the speaker".
    Play/pause resumes on the same device and says Playing / Paused /
    Nothing to play. K1 was mapped to Back, which nothing could reach under
    the faceplate; joystick-left still goes back.
    Simulator: + / - for volume, space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
2026-10-20 Crisper skip and shuffle icons on the home screen
    The "<<" / ">>" text and the line-drawn shuffle icon came out jagged on
    the 128x64 OLED. New pixel-art icons (display/icons.py, drawn a run of
    pixels at a time so they look the same on the Pi and in the simulator):
    |<< and >>| for skip, and crossing arrows on clean 45° diagonals for
    shuffle. Shuffle on now shows the icon cut out of a lit badge instead of
    a 2-pixel dot at the screen's edge.
2026-10-20 Faceplate hides the joystick's base; printed nub and button caps
    Faceplate: the joystick's housing tucks up into a pocket underneath, so
    only a 5 mm hole for the stem shows. A printed nub (like Adafruit's 4697:
    tapered post, raised arrows) grips the stem's square sections and hides
    its round collar; joystick_nub_test.py prints socket sizes to pick from.
    The three buttons beside the screen get printed caps (+, -, play/pause):
    a flange trapped under the faceplate, a body through it. check.py: the
    nub clears everything pushed over 9° each way, the stem tilts freely,
    the caps move freely and can't come out.
2026-10-20 Log track changes while a tag is down, flagging off-album tracks
2026-10-20 Print the playlist's name across the bottom of playlist prints
    Album prints are unchanged; auto playlists (name unreadable) print plain.
2026-10-20 Playlist prints ask whether to add the name
    Always asked, Yes first; Back cancels the print. Album prints don't ask,
    and auto playlists (no readable name) skip the question.
2026-10-20 Bottom button (K3) is Menu; lifting the album is pause
    Menu opens the menu from home and closes it straight back to home from any
    depth (Back over a prompt). Play/pause stays in the code, on space in the sim.
    K3's printed cap gets a three-bar menu icon.
2026-10-20 Playlist-name test: set the playlist before its step starts
    The step runs on its own thread and could read ctx.data first (flaky on CI).
2026-10-21 Joystick: up cycles repeat, hold left/right to scrub; cross layout
    Home screen icons sit like the joystick: repeat over shuffle, skips between.
    Left/right skip when let go, so a hold can scrub instead (seeks sent about
    once a second while held, then on release). The menu button, or Back, opens
    the menu from home now that up is repeat.
2026-10-21 Joystick press cycles the display: now playing, time, album
    CD-player style: seven-segment track number and elapsed time with RPT/RND
    flags and a progress bar; album screen with track of total and the album's
    length (one lookup per album, remembered). Drawn with rectangles, so the
    same on every display.
2026-10-21 Joystick nub socket 2.50 mm from the fit test; finer second test
2026-10-21 Button caps: 0.3 mm above the flange (was 0.15), flange 0.5 mm
    Screwing the faceplate down firmly bowed the board enough to press a button.
2026-10-21 Button caps: flange beside the plunger, from measured switch heights
    The plunger top is 2.46 mm, not 2.0 (that was the case), so caps sat 0.46 mm
    high and the faceplate pressed them. The plunger now comes up through an
    opening in the flange and pushes on the cap's body, which keeps the flange low
    enough under the faceplate. Checks: pressed caps touch only the plungers;
    caps at rest don't press them.
2026-10-21 Joystick nub socket 2.53 mm (fit test C)
2026-10-21 Raised symbols on caps and nub 0.48 mm (was 0.3): easier to feel, solid in an accent colour
2026-10-21 Side buttons were upside down: top is volume up, bottom is menu
    K1's pin is the bottom button on the hardware, not the top.
2026-10-21 Joystick nub sits 0.5 mm higher for more press travel
    Its skirt round the stem is 0.5 mm (was 1.0): 1.4 mm above the faceplate
    upright, ~0.9 leaning. New check: the nub can be pressed in 0.6 mm, upright
    or leaning, without bottoming on the faceplate.
2026-10-21 Album prints ask whether to add the name too, No first
    The label on an album is its name with the artist underneath. Labels fade
    to dark in step with how much text there is, and the text has a soft
    shadow, so they read over busy or light covers.
2026-10-22 Joystick nub: flat bottom on the stem's round section, flared socket entrance
    No skirt round the round section, so the nub prints flat on the bed with
    no overhang inside, and sits 1.9 mm above the faceplate (1.4 leaning) for
    more press travel. A 0.5 mm flared entrance offsets first-layer squish.
2026-10-22 Joystick nub holds only the stem, 0.8 mm clear of its round section
    The centre click slides the stem down through the round section, which
    stays put; the nub sat on it, so pressing pushed the wrong part. New check:
    the pressed nub clears the round section.
2026-10-22 Tag writing: never overwrite the album on the reader; Write Tag in the menu; ask before skipping
    The print's tag step used to write the first tag the reader saw, so an
    album left on the reader got the new print's link. Now it waits for that
    tag to be lifted off, reads the tag that's placed, writes only to that one,
    and asks before overwriting a tag that holds something else (No first).
    Back asks "Skip the tag?" (No first) instead of skipping straight away.
    Menu > Write Tag writes what's playing (its album, or its playlist) to a
    tag, for fixing one; the tag can stay on the reader, behind the same
    overwrite question.
2026-10-22 Screen's I2C bus at 400 kHz on every box; README: set the HAT to I2C
    Measured on the box: a full screen update went from 159 ms (6 fps) to 38 ms
    (26 fps), and the app reads the buttons in the same loop. upgrade.sh adds
    the boot setting (setup runs it, so does every update); it applies at the
    next reboot.
2026-10-22 Album tags carry the album's Apple Music link too, after the Spotify one
    For Sonos + Apple Music households later. Matched by artist, album name and
    track count via Apple's public iTunes search (a barcode alone lands on
    deluxe/anniversary reissues); no sure match, Spotify only. The Spotify link
    stays first, so boxes play exactly as before. A tag that already has the
    album's Spotify link gets the Apple link added without the overwrite
    question. Playlists stay Spotify-only.
2026-10-22 Wider button caps: 7.0 x 3.8 mm (was 5.0 x 3.4)
    Still centred on their switches. New check: a cap pressed at either end
    tips down to click its switch without catching on the faceplate.
2026-10-24 Play Spotify on Sonos through librespot's Connect route
    Spotify refuses Web API commands to Sonos (restricted devices), so tags
    could only pause a Sonos. Spotify's own apps steer Sonos through the
    internal Connect state service instead, which a librespot session can
    call too (as Spotifast does since Oct 2026).
    - connect-helper/: a small Rust helper on librespot-core 0.8 that signs
    in with Raspotify's saved login and forwards player commands
    - connect.py keeps one helper running and builds the commands
    - Choose Speaker lists Sonos rooms found on the network; a chosen Sonos
    is saved as restricted and tags and buttons go through the helper,
    with volume set over SoCo
    - Without the helper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
2026-10-25 CI: pin runner to ubuntu-24.04 so Python 3.9 stays available
    ubuntu-latest now resolves to Ubuntu 26.04, where actions/setup-python
    has no 3.9 build, so the 3.9 job fails at setup and cancels the others.
    Claude-Session: https://claude.ai/code/session_01VZJ2fPR21ecWX6gAKwTyzc
2026-10-25 CI: pin runner to ubuntu-24.04 so Python 3.9 stays available
    (cherry picked from commit 98cdbd40bdb14de361b18a0009e3623cc50e77ff)
    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
2026-10-25 Add Film Left menu option showing Instax shots remaining
    Connects to the printer just long enough to read its film count and
    battery, shows them on the OLED for a few seconds, then returns home.
    Printer off offers the same Retry/Cancel prompt as printing.
    Claude-Session: https://claude.ai/code/session_01CYXNkHSsFoTMbxNL2d48Pq
2026-10-25 CI: pin runner to ubuntu-24.04 so Python 3.9 stays available
    Same change as #3; no-ops once that merges.
    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
2026-10-25 Portal: use the Instant logo and outlined wordmark
    Swaps the header artwork for logo concept A (Instax Square frame with a
    record) and replaces the system-font title with the outlined DM Sans
    wordmark, so the portal matches the rest of the branding offline.
    Claude-Session: https://claude.ai/code/session_01HNNvjWKoQtg7q9Xutb13AT
2026-10-25 Show the Spotifactory logo on the OLED while booting
    startup.main() now draws a 128x64 1-bit splash (logo A: instant photo
    with a record, plus the wordmark) as soon as the display is up and keeps
    it on screen for at least 2 s while the network wait runs. A missing
    image or Pillow error is logged and skipped so boot never stalls.
    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
2026-10-25 Relay: use the shifted brand green on the login success page
    #1DB954 is Spotify's own green; #1DB96E matches the rest of the
    Spotifactory branding. Takes effect on the next wrangler deploy.
    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
2026-10-25 Add the spotifactory.com landing page
    Static page in site/ for Cloudflare Pages (output directory site, no build
    step), with favicon, link-preview image and the setup-portal screenshot.
    docs/website.md covers the Pages setup, custom domain and GitHub links.
    Uses the shifted brand green #1DB96E.
    Claude-Session: https://claude.ai/code/session_01TuwtPvwNTAgBcr1MLb96hW
2026-10-25 CI: pin runner to ubuntu-24.04 so Python 3.9 stays available
    Same change as b6b6e0e on portal-skin (#2); ubuntu-latest is now 26.04,
    which setup-python has no 3.9 build for. No-ops once main carries it.
    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
2026-10-25 Site: switch the accent to avocado chartreuse #A9C23F
    #5C6B1C for text on light backgrounds. Regenerates the favicon and the
    link-preview image.
    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
2026-10-25 Portal: switch brand colour to avocado #A9C23F
    The project's brand colour moved from green to a retro avocado; this
    updates the CSS accent, the logo record and the wordmark to match.
    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
2026-10-25 Relay: use the avocado brand colour on the login success page
    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
2026-10-26 Site: fuller build guide
    Adds the Spotify developer app setup, the list of STLs to print with how
    each sits on the bed, the heat-set inserts and base plate screws, and a
    copyable prompt for building with an AI assistant.
    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
2026-10-26 Now playing: track count and a thin progress bar
    The home screen's now-playing view shows which track of the album is
    playing ("3/12") left of the skip icons, and a progress bar along the
    bottom edge: dotted for the track, solid for the part played. The
    joystick cross moves up 3 px to clear it. While scrubbing, the scrub
    line stands in for the bar.
    Claude-Session: https://claude.ai/code/session_01BZPwFcaSg478rQT7J56g3r
2026-10-26 CI: pin the runner to Ubuntu 24.04
    ubuntu-latest is moving to Ubuntu 26.04, which has no Python 3.9 build,
    so the 3.9 job failed in setup-python before any test ran.
    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
2026-10-26 Site: downloadable STLs, real now-playing screen, soldering step
    - site/stl/: the seven case STLs and a zip, generated from enclosure/easel.py
    - Build page: download links, case renders, print layout, power-lead
    soldering step; no longer says no soldering
    - Hero and controls use the home screen rendered with the app's own icons;
    the drawing now has the joystick left of the screen and buttons right
    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
2026-10-26 Now playing: controls on the left, track count on the right
    The joystick sits on the left of the box, so the control cross moves to
    the left edge to match. The track count moves right, in the album
    screen's seven-segment digits with a new seven-segment '/'.
    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
2026-10-26 Now playing: a plain 3/12 track count on the right
    The seven-segment count was more than the main screen needs. It's now
    the regular font, right-aligned level with the skip icons; displays get
    a public text_width() for that (sim, OLED and SH1106). Drops the
    seven-segment '/' again.
    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
2026-10-26 Case files: build STLs in CI and link the site to the release
    A Case files workflow builds the STLs and renders from enclosure/easel.py
    on every case change on main and uploads them to the rolling case-files
    release. The build guide links there, so the site no longer carries
    generated STLs.
    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
2026-10-26 Site: say up front that the box prints the photos too
    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
2026-10-26 Site: the shared login relay is the default
    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
2026-10-26 Site: animate the three steps, drop the Apple Music tag note
    Steps are now print the album, stick on a tag, write the tag, each a
    small looping SVG scene (still under reduced motion). The tag screens
    are rendered with the app's own status layout.
    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
2026-10-26 Site: drop the fit-test prints from the build guide
    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
2026-10-26 Site: three side buttons in the controls picture
    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
2026-10-26 Nozzle: say 0.4 mm works (walls are six lines at 0.4)
    The build page and the enclosure comments assumed a 0.6 mm nozzle;
    2.4 mm walls are six lines at 0.4 mm, which is what the case is
    actually printed with.
    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
2026-10-26 Site: AI prompt needs no editing before pasting
    The last line had [bracketed] choices to fill in; it now asks the
    assistant to find those out instead.
    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
2026-10-26 Add Mouser BOM and more DigiKey parts
    Adds the Pi, SD card, cables and screws to the DigiKey import, a matching
    Mouser import, and enclosure/BOM.md listing both distributors' part numbers
    and the parts neither carries.
    Claude-Session: https://claude.ai/code/session_01Ac6vRx3NeuxyKrw6FAybEC
2026-10-27 Add an Amazon option for the power lead
    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
2026-10-28 Longer keeper posts for M2.5 x 20 screws
    The keeper screws stripped the posts in Polar Retro PLA: an M2.5 x 14 only
    threaded ~4.75 mm into the post. The posts grow from 14 to 20 mm and the
    pilot from 8 to 14 mm deep, so an M2.5 x 20 gets ~10.75 mm of thread.
    16 and 18 mm screws still fit. All enclosure checks pass.
2026-10-28 README: slicer settings for the enclosure
    Wall loops for screw posts that hold, brims and fan settings against the
    body's corners lifting, and not overtightening screws in PLA.
2026-10-28 Draw the boot logo early, before the network is up
    The app waits for network-online.target, so its splash appeared ~43 s
    into boot, though the OLED's I2C bus is there at ~12 s. A small oneshot,
    spotifactory-splash.service (DefaultDependencies=no, after local-fs and
    module loading), draws the logo as soon as /dev/i2c-1 exists and exits
    with luma's persist set, so the logo stays on screen until the app takes
    over and redraws it. upgrade.sh installs and enables it, so boxes in the
    field get it with their next update.
2026-10-28 Stencil for a vinyl square behind the photo's picture
    A dummy Instax Square print (72 x 86 x 1.6) with a 62 x 62 window where the
    picture is. It stands in the groove like a real print (checked against the
    body: no overlap, 0.17 mm off the panel), so the window marks the spot on
    the panel, and it doubles as a straight edge for cutting the vinyl.
2026-10-29 Site: click-to-play cover for the demo video
    Shows our own still (site/img/demo-poster.jpg) with a play button and
    loads the YouTube player only on click, so no YouTube branding or
    requests until then. Without JS the cover links to the video.
    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
2026-10-29 Site: switch the demo to the re-uploaded video with screen close-ups
    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
2026-11-03 Add a gallery page with photos and interactive 3D models
    New /gallery page: a photo grid with a lightbox (stills from the demo video
    plus a counter shot) and <model-viewer> 3D models of the assembled easel,
    tag dispenser and crate, with AR on phones. enclosure/web_models.py exports
    the GLBs from the build123d models. Gallery added to the nav on every page.
    Claude-Session: https://claude.ai/code/session_01R2PyoPE5DRroXDGk9HWbKq
2026-11-03 Gallery models: avocado colour, tag tail on the dispenser, empty crate
    The cream read as a flat white shape on screen, partly because the hex
    colours went into glTF unconverted (base colours are linear). Convert from
    sRGB and show the printed parts in the avocado brand colour so the shading
    reads. The dispenser now has a short tail of backing with a tag sticking up
    out of the slit instead of the paper run over the front, and the crate is
    shown empty.
    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
2026-11-04 Gallery: add the retro clock screen and print prompt photos
    Two more of Joe's photos (retro track/time screen, Print Album prompt).
    Drop the washed-out "Album ready" video still and order the photos so the
    three masonry columns come out about even.
    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
2026-11-06 Serve the auth relay on auth.spotifactory.com, keep workers.dev live (#22)
    Add a custom-domain route to the relay Worker alongside workers.dev and
    point the default RELAY_URL and setup docs at the new address. Existing
    boxes keep their .env (updates never rewrite RELAY_URL) and keep using
    the workers.dev address, which stays on.
    Claude-Session: https://claude.ai/code/session_01R2PyoTMTqKrvntKfJFCRae
2026-11-06 Setup: make several boxes coexist, quiet warnings, survive a bad relay URL (#23)
    * Quiet setup.sh: fix /etc/hosts first, SPDX license string
    A fresh Imager install can leave the hostname out of /etc/hosts, so every
    sudo in setup.sh printed 'unable to resolve host spotifactory'. Set the
    hostname and its 127.0.1.1 line before anything else.
    pyproject.toml: license as an SPDX string (setuptools >= 77) to drop the
    project.license deprecation block printed during pip install.
    Claude-Session: https://claude.ai/code/session_01R2PyoQrr5yBU5VkLB3DMD8
    * setup.sh: keep the Imager hostname so several boxes can share a network
    setup.sh forced e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
2026-11-12 Add a music backend layer; let Menu leave the first-boot login (#27)
    First step towards an opt-in Music Assistant mode. The UI now talks to
    music through spotifactory.backend instead of importing spotify.py, so a
    second service can be added in one place. Spotify stays the only backend
    and behaves as before.
    - backend/: a facade that looks the backend up per call (MUSIC_BACKEND,
    default spotify), plus shared types (NowPlayingInfo, ChosenDevice, TagPlay)
    - spotify.py: takes over the tag speaker-picking from the home screen
    (play_tag/stop_tag), print pause/resume, speaker listing incl. idle
    Sonos rooms, and pick_uri
    - Tags play their first Spotify link, not their first link, so tags that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
2026-11-12 Music Assistant mode: backend, Music Source menu, Squeezelite (#28)
    Opt-in for advanced users. Menu > Music Source > Music Assistant serves a
    setup page (QR code) for the server address and token, then the box shows
    and prints what Music Assistant is playing, lists its players as speakers,
    and runs Squeezelite instead of Raspotify so its Bluetooth speaker is a
    Music Assistant player. Tags carry the album's share links. Nothing talks
    to Spotify in this mode.
    Claude-Session: https://claude.ai/code/session_01R2PyoRXLrKRi78GH2kZJnF
